YiChenHai7296/PendulumDriveFW/readme.md

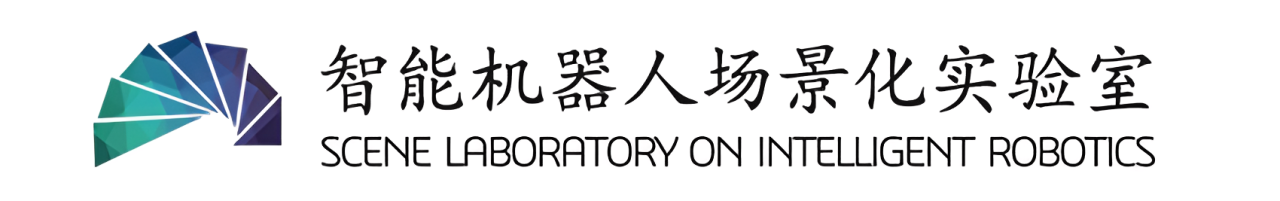
[picture p1: docs/images/IFR.png]
实验室Logo

# PendulumDriveFW
软尺摆 / 倒立摆通用驱动控制板固件工程（当前软件版本 V2.0）。

## 📖 文档

- **[摆系统通用驱动板总体方案V1.0](docs/摆系统通用驱动板总体方案V1.0.md)** — 通用驱动板的硬件与固件系统总体设计说明（需求、电路、软件架构、可测试性）
- **[摆系统单片机程序编码规范V1.2](docs/摆系统单片机程序编码规范V1.2.md)** — 摆系统单片机裸机固件编码规范：分层架构、文件分区、命名与注释约定（V1.2）
- **[摆系统通用驱动板硬件精度测试_260428](docs/摆系统通用驱动板硬件精度测试_260428.md)** — 通用驱动板 PWM 占空比映射与 ADC 采样精度硬件测试记录（V1.2 固件，2026-04-28）

## ✨ 更新日志：

| 版本号  | 修改人 | 日期 | 修改点 |
| ---- | --- | --- | --- |
| V1.0 | YiChenHai(xyf) | 260211 | 第一版完成工程，除摆杆编码器未启用外，基础功能齐全。 |
| V1.1 | YiChenHai(xyf) | 260327 | 初次上电时上传57mA电流采样异常值问题解决：模拟侧未稳定时进行了标定函数调用，上电后延迟再进行初始化； |
| | | | 添加零点标定功能； |
| | | | 摆杆编码器启用。 |
| V1.2 | YiChenHai(xyf) | 260330 | 米勒平台导致的PWM死区问题：以拟合公式消除死区； |
| | | | 驱动层上传数据接口memcpy可能被ISR打断问题。 |
| V1.3 | YiChenHai(xyf) | 260519 | 项目规范化：变量命名、函数命名、文件分区、软件分层； |
| | | | PWM线性映射重新测定：0~95%； |
| | | | 编码器首字节误码问题解决：TC中断切换过慢。 |
| V2.0 | YiChenHai(xyf) | 260622 | 对象选择功能加入； |
| | | | 软尺adc采集dma连续请求开启； |
| | | | 串口2波特率提升至921600； |
| | | | ADC、PWM自测函数以开关调用； |
| | | | 增加《摆系统通用驱动板总体方案V1.0》、《摆系统单片机程序编码规范V1.2》； |
| | | | 增加《摆系统通用驱动板硬件精度测试_260428》； |
| | | | 工程重命名，并按文档重构。 |

## 👤 开发者
contributors (https://github.com/YiChenHai7296/PendulumDriveFW/graphs/contributors)
