YiChenHai7296/PendulumDriveFW/docs/摆系统通用驱动板硬件精度测试_260428.md

# 1  测试目标
本文档记录摆系统通用驱动板在 V1.2 测试固件 下的硬件精度验证，重点确认以下两项是否满足控制与反馈需求：
## 1.1  PWM 给定占空比测试
验证上位机给定占空比经单片机 PWM 映射后，电机 H 桥两侧实际输出占空比是否与给定值一致，为后续占空比标定与转速控制提供依据。

## 1.2  ADC 精度测试
验证两路模拟采样链路的换算精度：
- 电机电流（ADC1 / ADC2）：PWM 高、低电平中心点采样；
- 软尺摆幅电压（ADC3）：外部电压输入采样。

对应系统需求：电流误差 < 10 mA，摆幅电压误差 < 10 mV。

# 2  测试版本

| 项目 | 版本 / 信息 |
| --- | --- |
| 硬件版本 | `DaoLiBai_BaseControlBoard_V2.1_260415` |
| 软件分支 | `SoftscalePendulumDriveBoard_V1.2_PWM+ADCtest_260428` |
| 软件 Commit | `394aa0fff4cecf73253746ea5f10786aba58eab4` |
| 测试日期 | 2026-04-28 |

# 3  测试方法
## 3.1  PWM给定占空比测试
**目的：** 对比「上位机给定占空比」与「示波器实测占空比」，以说明拟合函数的拟合精度。

**步骤：**
1. 在 H 桥输出端（图示引脚）飞出两根短测量线；
2. 差分表笔接入，测量电机两侧实际 PWM 占空比；
3. 上位机按 0.1%～99% 给定多组占空比，记录实测值并计算误差。

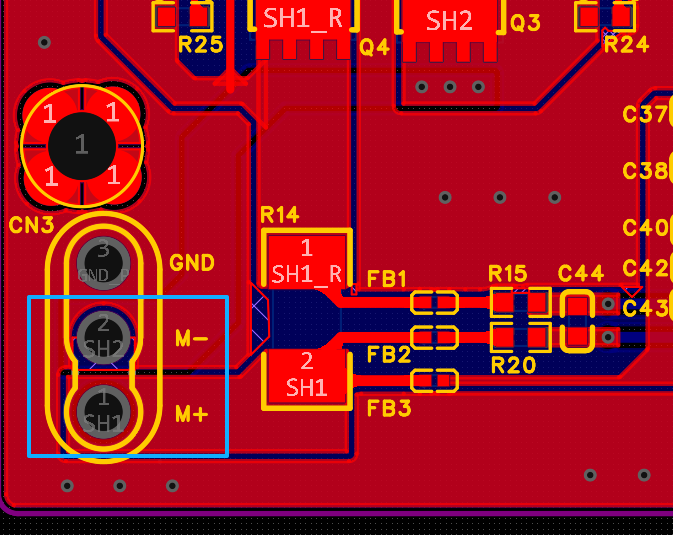
[picture p21: docs/images/硬件精度测试images/图01-PWM测试测量接线示意.png]
图01 PWM测试测量接线示意

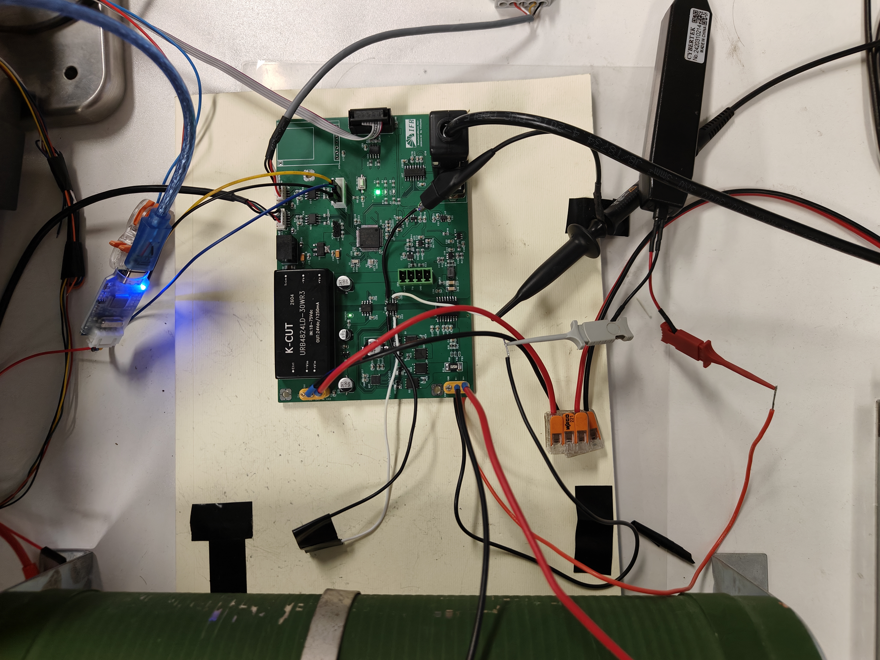
[picture p22: docs/images/硬件精度测试images/图02-PWM测试接线照片1.jpg]
图02 PWM测试接线照片1

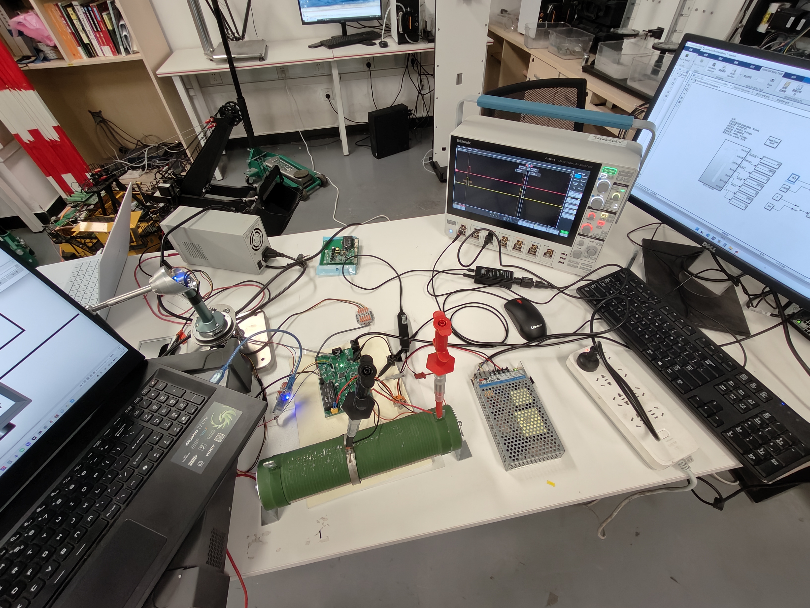
[picture p23: docs/images/硬件精度测试images/图03-PWM测试接线照片2.jpg]
图03 PWM测试接线照片2


## 3.2  ADC精度测试
- 打开调试输出

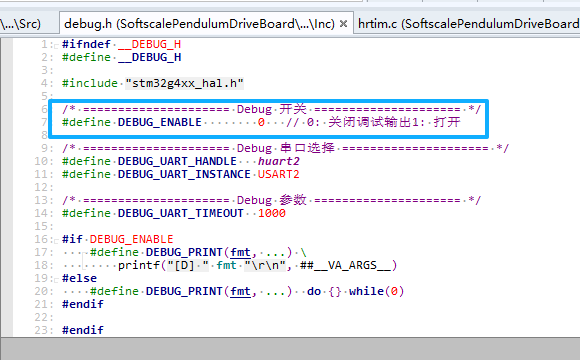
[picture p24: docs/images/硬件精度测试images/图04-打开调试输出.png]
图04 打开调试输出


- 根据实验选择输出模式

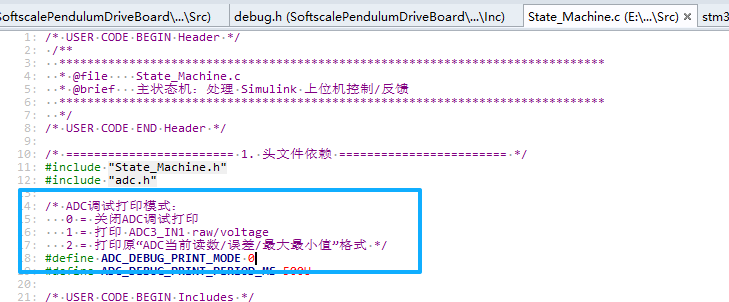
[picture p25: docs/images/硬件精度测试images/图05-选择输出模式.png]
图05 选择输出模式


### 3.2.1  电机ADC测量
**换算公式：**
$$I_{电机}=\frac{V_{adc}−1.6 V}{41×R_{14}}$$

其中 R14=0.002 Ω。

**接线：** 
	图示采样回路处串联电流表和功率电阻，由表计读数得到实际电流；与单片机 ADC 换算电流对比。
图06 电机ADC测量接线示意
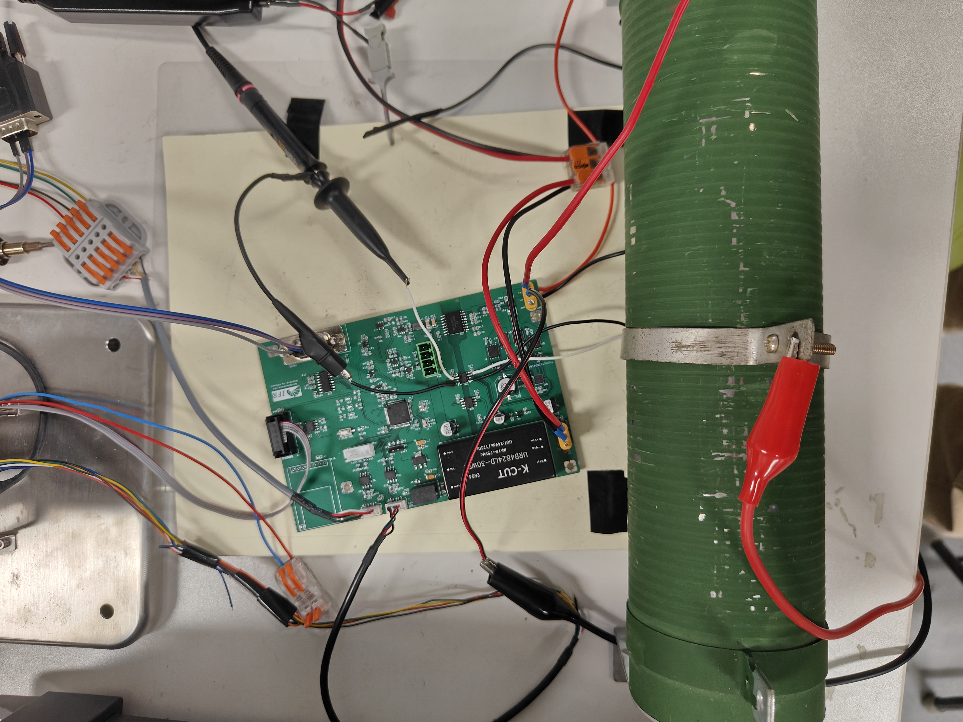
[picture p26: docs/images/硬件精度测试images/图07-电机ADC测量照片1.jpeg]
图07 电机ADC测量照片1

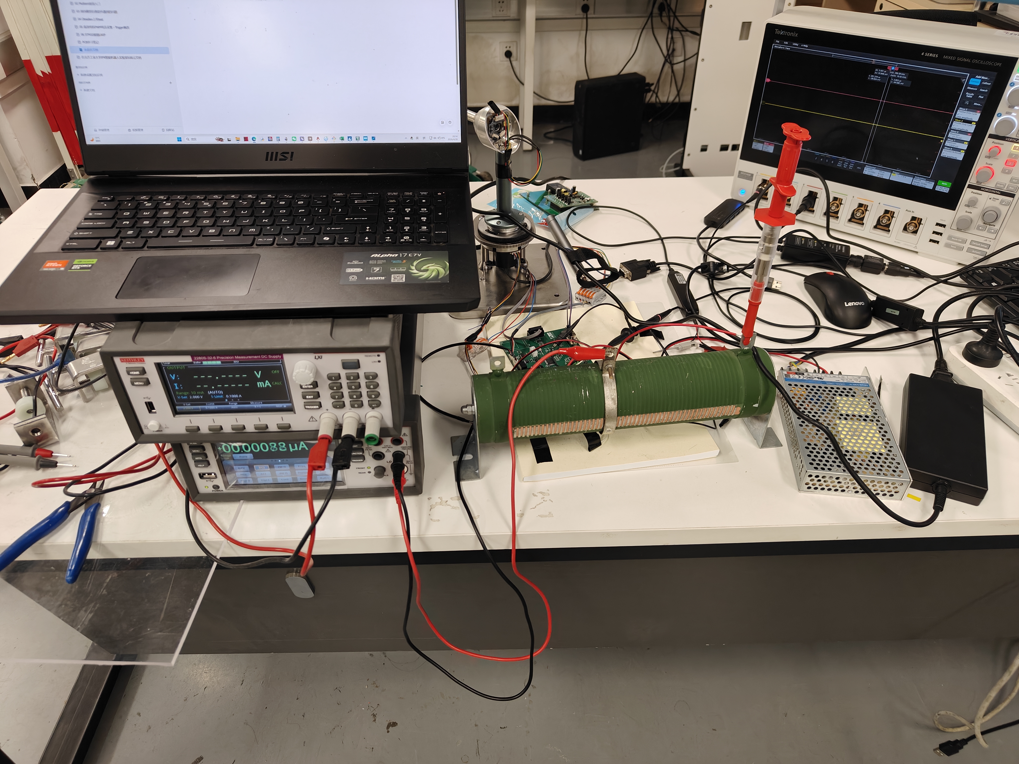
[picture p27: docs/images/硬件精度测试images/图08-电机ADC测量照片2.jpeg]
图08 电机ADC测量照片2

### 3.2.2  软尺摆ADC测量
**换算公式：**
$$V_{in}=\frac{V_{adc}−1.6 V}{0.16}$$

**接线：**
	在图示处直接使用高精度信号发生器**给定测量电压**，经公式计算后与单片机adc读取值比对。
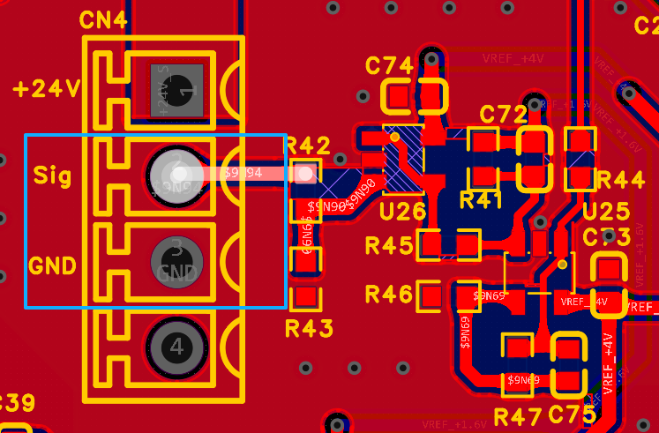
[picture p28: docs/images/硬件精度测试images/图09-软尺摆ADC测量接线示意.png]
图09 软尺摆ADC测量接线示意

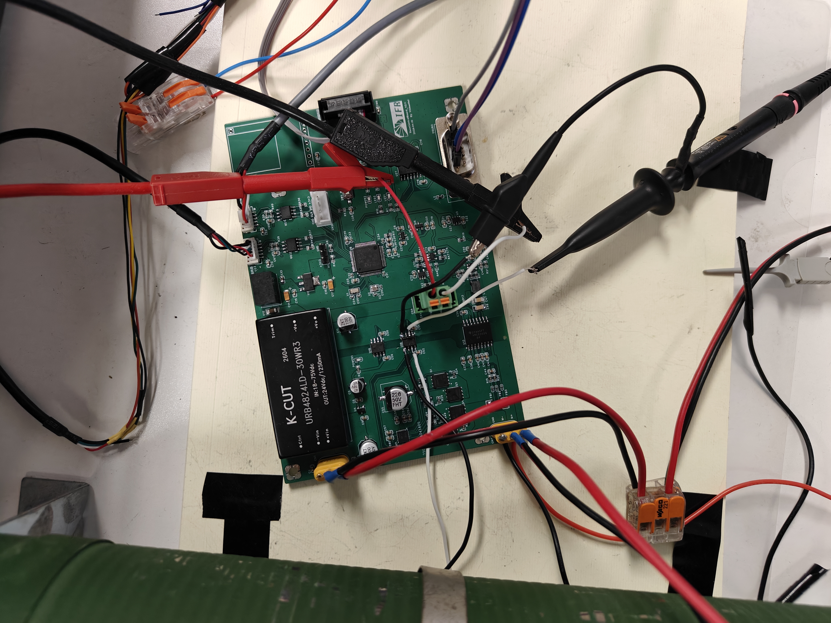
[picture p29: docs/images/硬件精度测试images/图10-软尺摆ADC测量照片1.jpeg]
图10 软尺摆ADC测量照片1

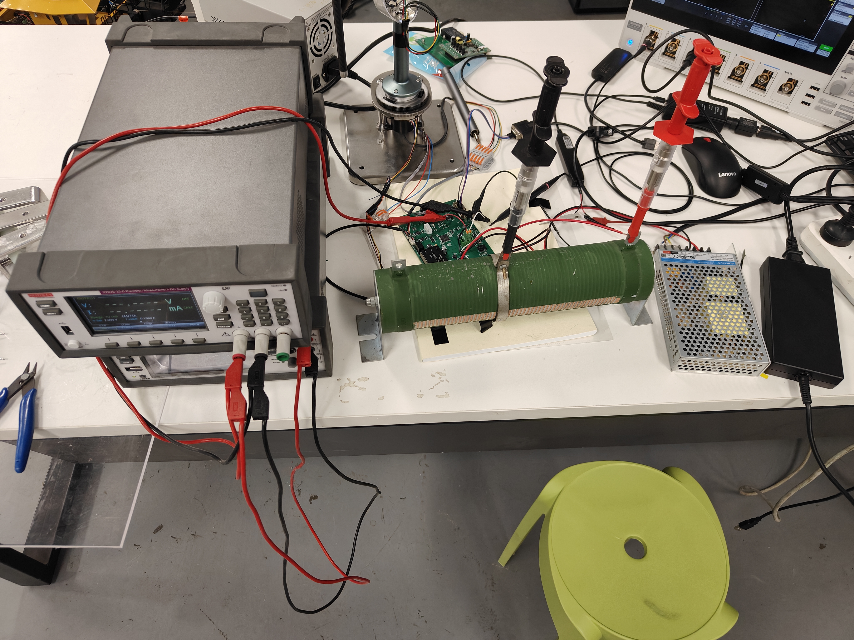
[picture p30: docs/images/硬件精度测试images/图11-软尺摆ADC测量照片2.jpeg]
图11 软尺摆ADC测量照片2

# 4  测试结果
## 4.1  PWM给定测试
### 4.1.1  数据整理
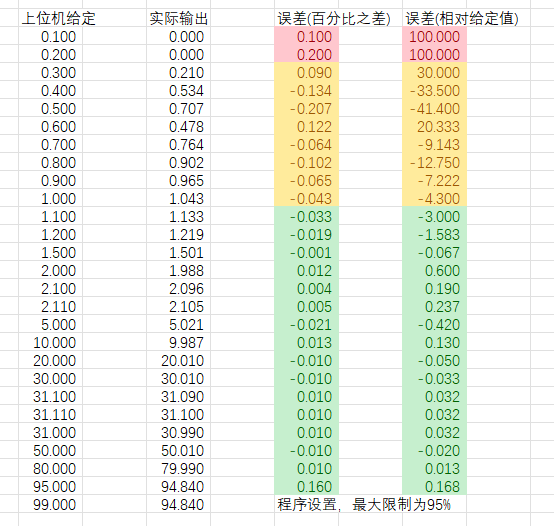
[picture p31: docs/images/硬件精度测试images/图12-PWM测试结果数据整理.png]
图12 PWM测试结果数据整理

### 4.1.2  测试结论

| 给定占空比区间 | 实测表现 | 相对误差（典型） |
| --- | --- | --- |
| 0.1%～0.2% | 实测为 0，无有效输出 | 死区 |
| 0.3%～1.0% | 有输出但偏差较大 | 约 ±30%～±40% |
| ≥ 1.1% | 跟踪明显改善 | 多数 < 3% |
| ≥ 2.0% | 精度稳定 | 多数 < 1%（如 10% 给定误差约 0.13%） |
| 99% 给定 | 实测约 94.84%  | 受固件最大占空比 95% 限制 |

1. 低占空比死区明显： 给定 ≤ 0.2% 时实测为 0，与固件死区阈值（约 0.08%）及驱动芯片、H 桥开启特性一致；0.3%～1.0% 区间误差仍较大，不宜作为精确调速区。
2. 有效调速区精度良好： 给定 ≥ 2.0% 时，相对误差多数 < 1%，满足万分之一给定精度下的实际控制需求。
3. 上限受软件限制： 给定 99% 时输出约 94.84%，与程序 95% 占空比上限 一致，属预期行为。

**结论：** PWM 映射在 ≥ 2% 占空比 范围内可用；低占空比区需依赖标定表/死区补偿，与正式固件 `MOTOR_PWM_USE_FIT_MAPPING` 策略一致。

### 4.1.3  原始数据
见附件 260428 PWM拟合测试示波器截图

## 4.2  ADC精度测试
### 4.2.1  数据整理
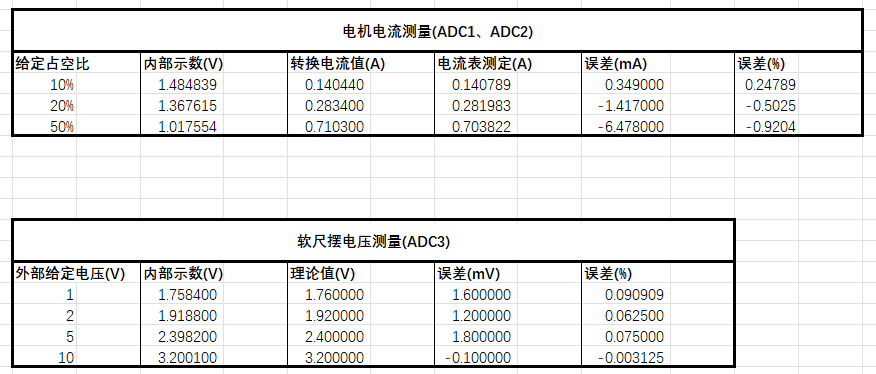
[picture p32: docs/images/硬件精度测试images/图13-ADC测试结果数据整理.png]
图13 ADC测试结果数据整理


### 4.2.2  测试结论
1. 电机电流： 相对误差 < 1%，绝对误差最大约 6.5 mA（50% 工况），满足 < 10 mA 指标。
2. 软尺摆电压： 测试点误差 < 2 mV，相对误差 < 0.1%，满足 < 10 mV 指标。

**结论：** 两路 ADC 采样链路（含隔离放大、偏置与换算公式）精度达标，可作为闭环反馈与软尺摆模式摆幅上报的可靠数据来源。

### 4.2.3  原始数据
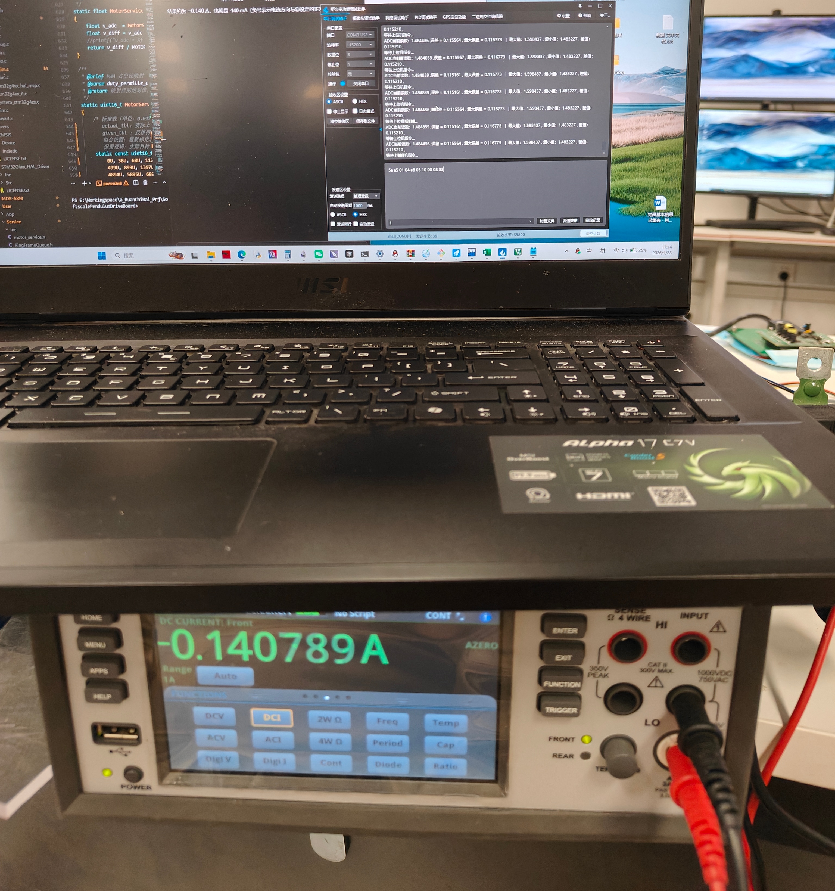
[picture p33: docs/images/硬件精度测试images/图14-ADC原始数据照片1.jpg]
图14 ADC原始数据照片1

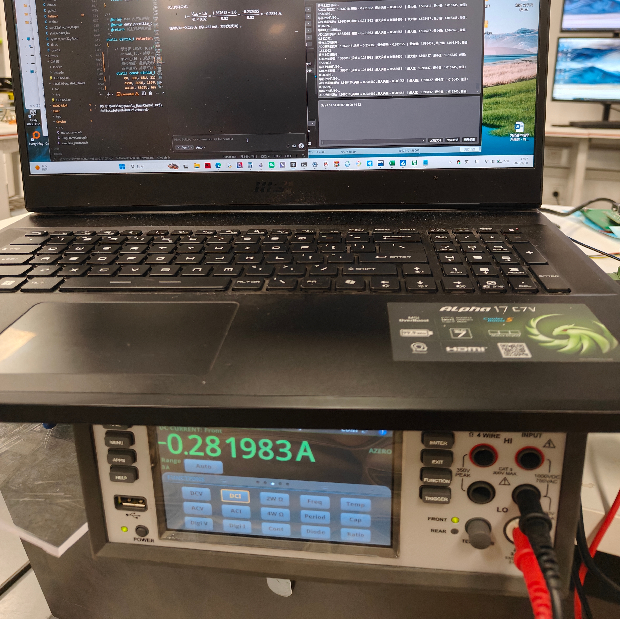
[picture p34: docs/images/硬件精度测试images/图15-ADC原始数据照片2.jpg]
图15 ADC原始数据照片2

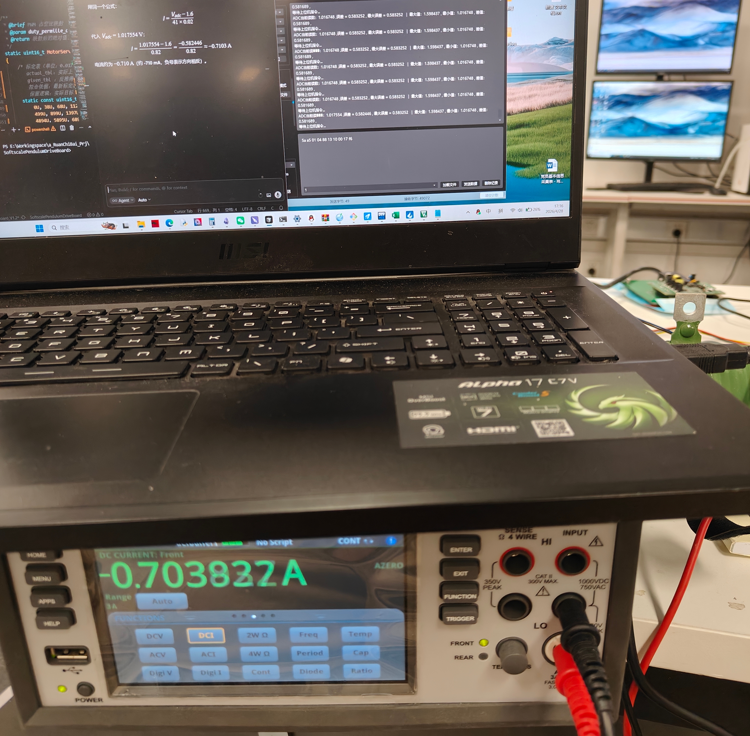
[picture p35: docs/images/硬件精度测试images/图16-ADC原始数据照片3.jpg]
图16 ADC原始数据照片3


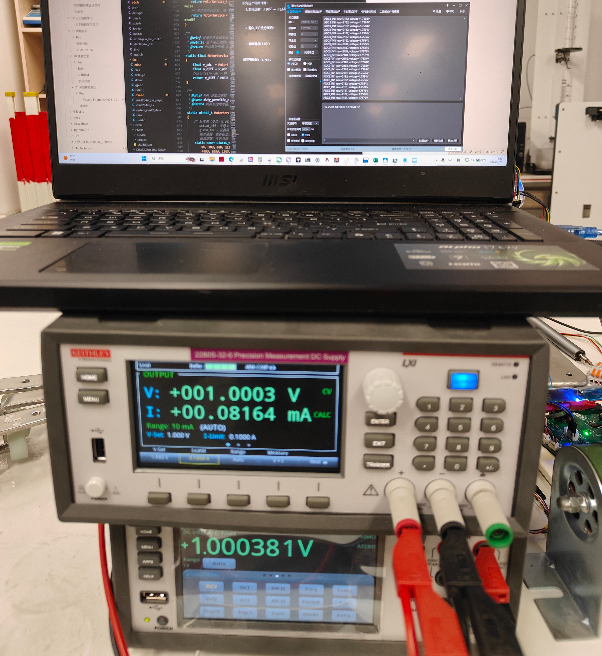
[picture p36: docs/images/硬件精度测试images/图17-ADC原始数据照片4.jpg]
图17 ADC原始数据照片4

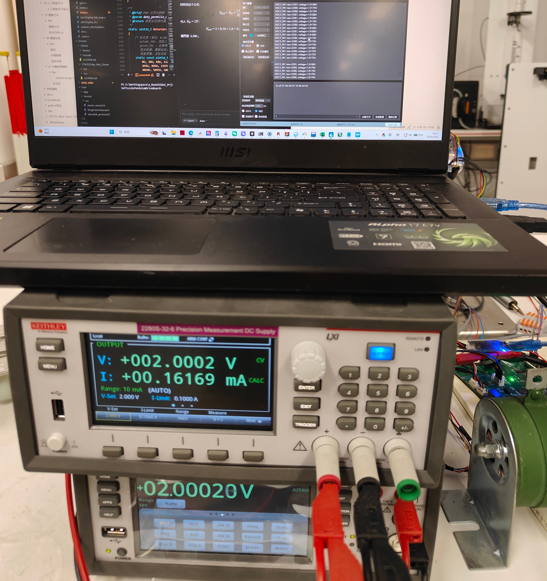
[picture p37: docs/images/硬件精度测试images/图18-ADC原始数据照片5.jpg]
图18 ADC原始数据照片5

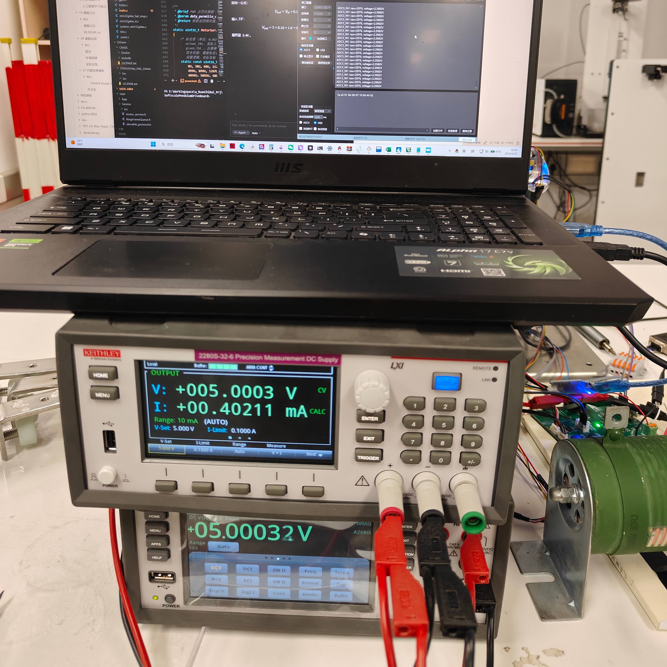
[picture p38: docs/images/硬件精度测试images/图19-ADC原始数据照片6.jpg]
图19 ADC原始数据照片6

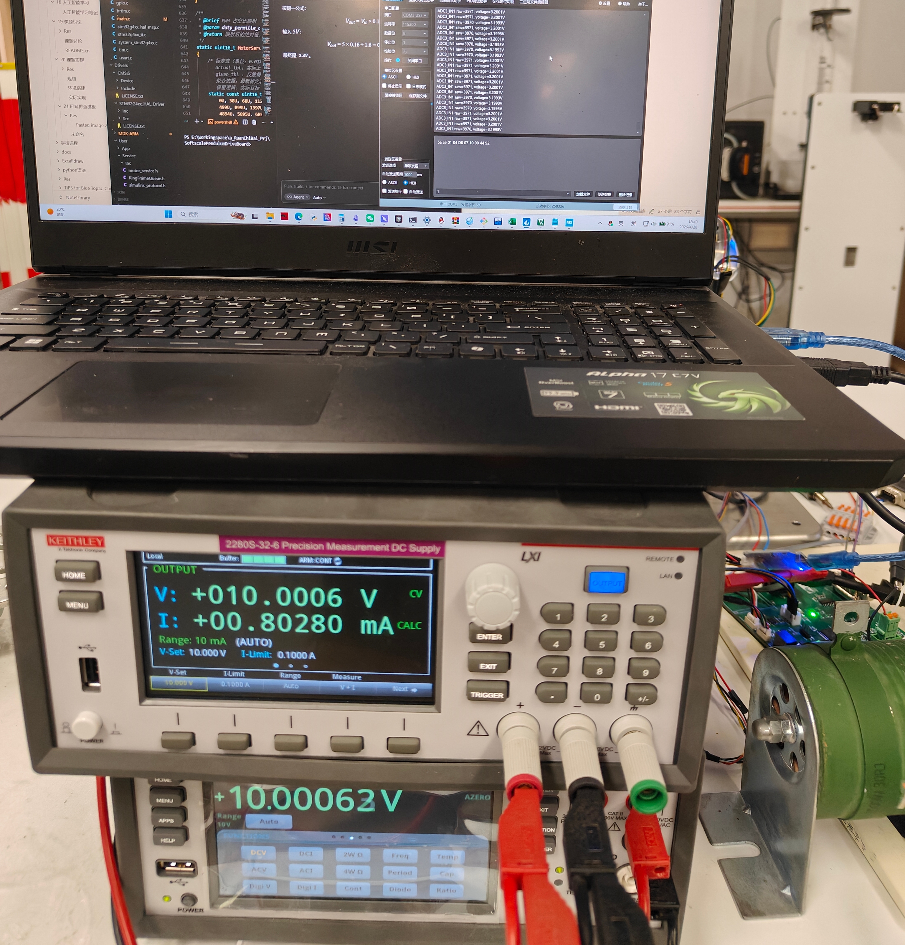
[picture p39: docs/images/硬件精度测试images/图20-ADC原始数据照片7.jpg]
图20 ADC原始数据照片7
