YiChenHai7296/PendulumDriveFW/Core/Src/main.c

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
/* Includes ------------------------------------------------------------------*/
#include "main.h"
#include "hrtim.h"


void SystemClock_Config(void);
/* USER CODE BEGIN 0 */

/* ======================== 1. 头文件引用（本文件额外） ======================== */
#include "bsp.h"              /* Bsp_Init / Bsp_Ms_Delay；Error_Handler 内 BSP_LOG_PRINTF */
#include "adc.h"              /* TEST_DRV+TEST_ADC 自测时调用 Drv_ADC_TEST */
#include "hrtim.h"            /* TEST_DRV+TEST_PWM 自测时调用 Drv_PWM_TEST */
#include "State_Machine.h"    /* App_StateMachine_MainLoop */

/* ======================== 2. 私有宏定义 ======================== */
/*
 * 驱动自测开关 TEST_DRV / TEST_ADC / TEST_PWM 已集中至 `User/Config/Inc/config.h`（调试开关分区），
 * 经上方 bsp.h 透传 config.h 可见，此处仅保留组合合法性校验。
 * - TEST_DRV=0：正常应用，调用 App_StateMachine_MainLoop()（永不返回）。
 * - TEST_DRV=1：进入下方自测死循环；IWDG 仍依赖 TIM2 更新中断内 HAL_IWDG_Refresh。
 * - TEST_ADC 仅在 TEST_DRV=1 时生效：1 周期调用 Drv_ADC_TEST()；0 不调用。
 * - TEST_PWM 仅在 TEST_DRV=1 时生效：1 周期调用 Drv_PWM_TEST()；0 不调用。
 */
#if (TEST_ADC != 0) && (TEST_DRV == 0)
#error "TEST_ADC=1 时必须同时 TEST_DRV=1，否则主循环不会调用 Drv_ADC_TEST"
#endif
#if (TEST_PWM != 0) && (TEST_DRV == 0)
#error "TEST_PWM=1 时必须同时 TEST_DRV=1，否则主循环不会调用 Drv_PWM_TEST"
#endif

/* ======================== 3. 私有类型定义 ======================== */
/* 无 */

/* ======================== 4. 对外变量定义 ======================== */
/* 无 */

/* ======================== 5. 私有变量 ======================== */
/* 无 */

/* ======================== 6. 私有函数声明 ======================== */
/* 无 */

/* USER CODE END 0 */

/**
  * @brief  The application entry point.
  * @retval int
  */
int main(void)
{

  /* MCU Configuration--------------------------------------------------------*/

  /* Reset of all peripherals, Initializes the Flash interface and the Systick. */
  HAL_Init();

  /* Configure the system clock */
  SystemClock_Config();

  /* Initialize all configured peripherals */
  /* USER CODE BEGIN 2 */
  /* 外设 MX 初始化与 HRTIM 启动（HAL_Init / SystemClock_Config 已由上方 Cube 模板完成） */
  Bsp_Init();
  
  /* USER CODE END 2 */

  /* Infinite loop */
  /* USER CODE BEGIN WHILE */
  BSP_LOG_PRINTF_FORCE("\n==========================================================");
  BSP_LOG_PRINTF_FORCE("\n  PendulumDriverFW V%s  ;  控制对象: %s  ;  编译日期: %s %s.\n", VERSION_NUM_STR, APP_CONTROL_OBJECT_NAME_STR, __DATE__, __TIME__);
  BSP_LOG_PRINTF_FORCE("==========================================================\n\n");

#if TEST_DRV
  /* 驱动自测：不调用应用状态机；IWDG 仍依赖 TIM2 更新中断内 HAL_IWDG_Refresh */
  while (1)
  {
#if TEST_ADC
    Drv_ADC_TEST();
    Bsp_Ms_Delay(500);
#endif
#if TEST_PWM
    Drv_PWM_TEST();
#endif
  }
#else
  App_StateMachine_MainLoop();
#endif

  while (1)
  {
    /* USER CODE END WHILE */

    /* USER CODE BEGIN 3 */
  }
  /* USER CODE END 3 */
}

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
/* USER CODE BEGIN 4 */

/* ======================== 7. 接口函数实现 ======================== */
/* 无 */

/* ======================== 8. 私有函数实现 ======================== */
/* 无 */

/* ======================== 9. HAL 回调函数实现 ======================== */
/* 无 */

/* USER CODE END 4 */
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
