YiChenHai7296/PendulumDriveFW/PendulumDriveFW.ioc

Mcu.UserName=STM32G474RETx
PA0.Signal=ADC1_IN1
PA1.Signal=ADC2_IN2
PA11.GPIO_Label=LED_BLUE
PA11.Signal=GPIO_Output
PA12.GPIO_Label=LED_RED
PA12.Signal=GPIO_Output
PA13.Signal=SYS_JTMS-SWDIO
PA14.Signal=SYS_JTCK-SWCLK
PA15.Signal=USART2_RX
PA2.Signal=USART2_TX
PA8.Signal=HRTIM1_CHA1
PB1.Signal=ADC3_IN1
PB10.Signal=USART3_TX
PB11.Signal=USART3_RX
PB4.GPIO_Label=Encoder_Motor_Enable
PB4.Signal=GPIO_Output
PB5.GPIO_Label=MotorEnableControl
PB5.Signal=GPIO_Output
PB6.GPIO_Label=MotorDirectionControl
PB6.Signal=GPIO_Output
PB9.GPIO_Label=Encoder_SwingArm_Enable
PB9.Signal=GPIO_Output
PC10.Signal=UART4_TX
PC11.Signal=UART4_RX
PC12.Signal=UART5_TX
PC13.GPIO_Label=Encoder_OutputShaft_Enable
PC13.Signal=GPIO_Output
PC14-OSC32_IN.Signal=RCC_OSC32_IN
PC15-OSC32_OUT.Signal=RCC_OSC32_OUT
PC4.Signal=USART1_TX
PC5.Signal=USART1_RX
PD2.Signal=UART5_RX
PF0-OSC_IN.Signal=RCC_OSC_IN
PF1-OSC_OUT.Signal=RCC_OSC_OUT
