YiChenHai7296/PendulumDriveFW/Core/Inc/main.h

#define Encoder_OutputShaft_Enable_Pin GPIO_PIN_13
#define Encoder_OutputShaft_Enable_GPIO_Port GPIOC
#define LED_BLUE_Pin GPIO_PIN_11
#define LED_BLUE_GPIO_Port GPIOA
#define LED_RED_Pin GPIO_PIN_12
#define LED_RED_GPIO_Port GPIOA
#define Encoder_Motor_Enable_Pin GPIO_PIN_4
#define Encoder_Motor_Enable_GPIO_Port GPIOB
#define MotorEnableControl_Pin GPIO_PIN_5
#define MotorEnableControl_GPIO_Port GPIOB
#define MotorDirectionControl_Pin GPIO_PIN_6
#define MotorDirectionControl_GPIO_Port GPIOB
#define Encoder_SwingArm_Enable_Pin GPIO_PIN_9
#define Encoder_SwingArm_Enable_GPIO_Port GPIOB
