YiChenHai7296/PendulumDriveFW/Core/Src/adc.c

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
/* Includes ------------------------------------------------------------------*/
#include "adc.h"

/* USER CODE BEGIN 0 */

/* ======================== 1. 头文件引用（本文件额外） ======================== */
#include <stdio.h>
#include "bsp.h"      /* BSP_LOG_PRINTF */

/* ======================== 2. 私有宏定义 ======================== */
#define ADC_DMA_RX_BUFF_LEN 1

/* ======================== 3. 私有类型定义 ======================== */
/* 无 */

/* ======================== 4. 对外变量定义 ======================== */
/* 无 */

/* ======================== 5. 私有变量 ======================== */
static __IO uint16_t s_au16ADC1VolValue[ADC_DMA_RX_BUFF_LEN]; /* 电机电压 ADC1 */
static __IO uint16_t s_au16ADC2VolValue[ADC_DMA_RX_BUFF_LEN];
static __IO uint16_t s_au16ADC3VolValue[ADC_DMA_RX_BUFF_LEN]; /* ADC3_IN1，HRTIM+DMA 循环缓冲 */
static volatile uint32_t s_u32MotorADCRawSnapshotPack = 0U;
static float s_fTestValue = 1.6f;                             /* ADC 测试输入电压值 */

/* ======================== 6. 私有函数声明 ======================== */
/* 无 */

/* USER CODE END 0 */

ADC_HandleTypeDef hadc1;
ADC_HandleTypeDef hadc2;
ADC_HandleTypeDef hadc3;
DMA_HandleTypeDef hdma_adc1;
DMA_HandleTypeDef hdma_adc2;
DMA_HandleTypeDef hdma_adc3;

/* ADC1 init function */
void MX_ADC1_Init(void)
{

  ADC_MultiModeTypeDef multimode = {0};
  ADC_ChannelConfTypeDef sConfig = {0};

  /** Common config
  */
  hadc1.Instance = ADC1;
  hadc1.Init.ClockPrescaler = ADC_CLOCK_SYNC_PCLK_DIV4;
  hadc1.Init.Resolution = ADC_RESOLUTION_12B;
  hadc1.Init.DataAlign = ADC_DATAALIGN_RIGHT;
  hadc1.Init.GainCompensation = 0;
  hadc1.Init.ScanConvMode = ADC_SCAN_DISABLE;
  hadc1.Init.EOCSelection = ADC_EOC_SINGLE_CONV;
  hadc1.Init.LowPowerAutoWait = DISABLE;
  hadc1.Init.ContinuousConvMode = DISABLE;
  hadc1.Init.NbrOfConversion = 1;
  hadc1.Init.DiscontinuousConvMode = DISABLE;
  hadc1.Init.ExternalTrigConv = ADC_EXTERNALTRIG_HRTIM_TRG1;
  hadc1.Init.ExternalTrigConvEdge = ADC_EXTERNALTRIGCONVEDGE_RISING;
  hadc1.Init.DMAContinuousRequests = ENABLE;
  hadc1.Init.Overrun = ADC_OVR_DATA_OVERWRITTEN;
  hadc1.Init.OversamplingMode = ENABLE;
  hadc1.Init.Oversampling.Ratio = ADC_OVERSAMPLING_RATIO_32;
  hadc1.Init.Oversampling.RightBitShift = ADC_RIGHTBITSHIFT_5;
  hadc1.Init.Oversampling.TriggeredMode = ADC_TRIGGEREDMODE_SINGLE_TRIGGER;
  hadc1.Init.Oversampling.OversamplingStopReset = ADC_REGOVERSAMPLING_CONTINUED_MODE;
  if (HAL_ADC_Init(&hadc1) != HAL_OK)
  {
    Error_Handler();
  }

  /** Configure the ADC multi-mode
  */
  multimode.Mode = ADC_MODE_INDEPENDENT;
  if (HAL_ADCEx_MultiModeConfigChannel(&hadc1, &multimode) != HAL_OK)
  {
    Error_Handler();
  }

  /** Configure Regular Channel
  */
  sConfig.Channel = ADC_CHANNEL_1;
  sConfig.Rank = ADC_REGULAR_RANK_1;
  sConfig.SamplingTime = ADC_SAMPLETIME_24CYCLES_5;
  sConfig.SingleDiff = ADC_SINGLE_ENDED;
  sConfig.OffsetNumber = ADC_OFFSET_NONE;
  sConfig.Offset = 0;
  if (HAL_ADC_ConfigChannel(&hadc1, &sConfig) != HAL_OK)
  {
    Error_Handler();
  }
  /* USER CODE BEGIN ADC1_Init 2 */

  Bsp_Ms_Delay(2000);/* 等待模拟前端稳定再校准 */
  if (HAL_ADCEx_Calibration_Start(&hadc1, ADC_SINGLE_ENDED) != HAL_OK)
  {
    Error_Handler();
  }

  if (HAL_ADC_Start_DMA(&hadc1, (uint32_t *)s_au16ADC1VolValue, ADC_DMA_RX_BUFF_LEN) != HAL_OK)
  {
    Error_Handler();
  }
  
  /* USER CODE END ADC1_Init 2 */

}
/* ADC2 init function */
void MX_ADC2_Init(void)
{

  ADC_ChannelConfTypeDef sConfig = {0};

  /** Common config
  */
  hadc2.Instance = ADC2;
  hadc2.Init.ClockPrescaler = ADC_CLOCK_SYNC_PCLK_DIV4;
  hadc2.Init.Resolution = ADC_RESOLUTION_12B;
  hadc2.Init.DataAlign = ADC_DATAALIGN_RIGHT;
  hadc2.Init.GainCompensation = 0;
  hadc2.Init.ScanConvMode = ADC_SCAN_DISABLE;
  hadc2.Init.EOCSelection = ADC_EOC_SINGLE_CONV;
  hadc2.Init.LowPowerAutoWait = DISABLE;
  hadc2.Init.ContinuousConvMode = DISABLE;
  hadc2.Init.NbrOfConversion = 1;
  hadc2.Init.DiscontinuousConvMode = DISABLE;
  hadc2.Init.ExternalTrigConv = ADC_EXTERNALTRIG_HRTIM_TRG6;
  hadc2.Init.ExternalTrigConvEdge = ADC_EXTERNALTRIGCONVEDGE_RISING;
  hadc2.Init.DMAContinuousRequests = ENABLE;
  hadc2.Init.Overrun = ADC_OVR_DATA_OVERWRITTEN;
  hadc2.Init.OversamplingMode = ENABLE;
  hadc2.Init.Oversampling.Ratio = ADC_OVERSAMPLING_RATIO_32;
  hadc2.Init.Oversampling.RightBitShift = ADC_RIGHTBITSHIFT_5;
  hadc2.Init.Oversampling.TriggeredMode = ADC_TRIGGEREDMODE_SINGLE_TRIGGER;
  hadc2.Init.Oversampling.OversamplingStopReset = ADC_REGOVERSAMPLING_CONTINUED_MODE;
  if (HAL_ADC_Init(&hadc2) != HAL_OK)
  {
    Error_Handler();
  }

  /** Configure Regular Channel
  */
  sConfig.Channel = ADC_CHANNEL_2;
  sConfig.Rank = ADC_REGULAR_RANK_1;
  sConfig.SamplingTime = ADC_SAMPLETIME_24CYCLES_5;
  sConfig.SingleDiff = ADC_SINGLE_ENDED;
  sConfig.OffsetNumber = ADC_OFFSET_NONE;
  sConfig.Offset = 0;
  if (HAL_ADC_ConfigChannel(&hadc2, &sConfig) != HAL_OK)
  {
    Error_Handler();
  }
  /* USER CODE BEGIN ADC2_Init 2 */
  if (HAL_ADCEx_Calibration_Start(&hadc2, ADC_SINGLE_ENDED) != HAL_OK)
  {
    Error_Handler();
  }

  if (HAL_ADC_Start_DMA(&hadc2, (uint32_t *)s_au16ADC2VolValue, ADC_DMA_RX_BUFF_LEN) != HAL_OK)
  {
    Error_Handler();
  }


  /* USER CODE END ADC2_Init 2 */

}
/* ADC3 init function */
void MX_ADC3_Init(void)
{

  ADC_MultiModeTypeDef multimode = {0};
  ADC_ChannelConfTypeDef sConfig = {0};

  /** Common config
  */
  hadc3.Instance = ADC3;
  hadc3.Init.ClockPrescaler = ADC_CLOCK_SYNC_PCLK_DIV4;
  hadc3.Init.Resolution = ADC_RESOLUTION_12B;
  hadc3.Init.DataAlign = ADC_DATAALIGN_RIGHT;
  hadc3.Init.GainCompensation = 0;
  hadc3.Init.ScanConvMode = ADC_SCAN_DISABLE;
  hadc3.Init.EOCSelection = ADC_EOC_SINGLE_CONV;
  hadc3.Init.LowPowerAutoWait = DISABLE;
  hadc3.Init.ContinuousConvMode = DISABLE;
  hadc3.Init.NbrOfConversion = 1;
  hadc3.Init.DiscontinuousConvMode = DISABLE;
  hadc3.Init.ExternalTrigConv = ADC_EXTERNALTRIG_HRTIM_TRG6;
  hadc3.Init.ExternalTrigConvEdge = ADC_EXTERNALTRIGCONVEDGE_RISING;
  hadc3.Init.DMAContinuousRequests = ENABLE;
  hadc3.Init.Overrun = ADC_OVR_DATA_PRESERVED;
  hadc3.Init.OversamplingMode = ENABLE;
  hadc3.Init.Oversampling.Ratio = ADC_OVERSAMPLING_RATIO_32;
  hadc3.Init.Oversampling.RightBitShift = ADC_RIGHTBITSHIFT_5;
  hadc3.Init.Oversampling.TriggeredMode = ADC_TRIGGEREDMODE_SINGLE_TRIGGER;
  hadc3.Init.Oversampling.OversamplingStopReset = ADC_REGOVERSAMPLING_CONTINUED_MODE;
  if (HAL_ADC_Init(&hadc3) != HAL_OK)
  {
    Error_Handler();
  }

  /** Configure the ADC multi-mode
  */
  multimode.Mode = ADC_MODE_INDEPENDENT;
  if (HAL_ADCEx_MultiModeConfigChannel(&hadc3, &multimode) != HAL_OK)
  {
    Error_Handler();
  }

  /** Configure Regular Channel
  */
  sConfig.Channel = ADC_CHANNEL_1;
  sConfig.Rank = ADC_REGULAR_RANK_1;
  sConfig.SamplingTime = ADC_SAMPLETIME_24CYCLES_5;
  sConfig.SingleDiff = ADC_SINGLE_ENDED;
  sConfig.OffsetNumber = ADC_OFFSET_NONE;
  sConfig.Offset = 0;
  if (HAL_ADC_ConfigChannel(&hadc3, &sConfig) != HAL_OK)
  {
    Error_Handler();
  }
  /* USER CODE BEGIN ADC3_Init 2 */
  if (HAL_ADCEx_Calibration_Start(&hadc3, ADC_SINGLE_ENDED) != HAL_OK)
  {
    Error_Handler();
  }

  if (HAL_ADC_Start_DMA(&hadc3, (uint32_t *)s_au16ADC3VolValue, ADC_DMA_RX_BUFF_LEN) != HAL_OK)
  {
    Error_Handler();
  }

  /* USER CODE END ADC3_Init 2 */

}

static uint32_t HAL_RCC_ADC12_CLK_ENABLED=0;

void HAL_ADC_MspInit(ADC_HandleTypeDef* adcHandle)
{

  GPIO_InitTypeDef GPIO_InitStruct = {0};
  RCC_PeriphCLKInitTypeDef PeriphClkInit = {0};
  if(adcHandle->Instance==ADC1)
  {
  /** Initializes the peripherals clocks
  */
    PeriphClkInit.PeriphClockSelection = RCC_PERIPHCLK_ADC12;
    PeriphClkInit.Adc12ClockSelection = RCC_ADC12CLKSOURCE_SYSCLK;
    if (HAL_RCCEx_PeriphCLKConfig(&PeriphClkInit) != HAL_OK)
    {
      Error_Handler();
    }

    /* ADC1 clock enable */
    HAL_RCC_ADC12_CLK_ENABLED++;
    if(HAL_RCC_ADC12_CLK_ENABLED==1){
      __HAL_RCC_ADC12_CLK_ENABLE();
    }

    __HAL_RCC_GPIOA_CLK_ENABLE();
    /**ADC1 GPIO Configuration
    PA0     ------> ADC1_IN1
    */
    GPIO_InitStruct.Pin = GPIO_PIN_0;
    GPIO_InitStruct.Mode = GPIO_MODE_ANALOG;
    GPIO_InitStruct.Pull = GPIO_NOPULL;
    HAL_GPIO_Init(GPIOA, &GPIO_InitStruct);

    /* ADC1 DMA Init */
    /* ADC1 Init */
    hdma_adc1.Instance = DMA1_Channel1;
    hdma_adc1.Init.Request = DMA_REQUEST_ADC1;
    hdma_adc1.Init.Direction = DMA_PERIPH_TO_MEMORY;
    hdma_adc1.Init.PeriphInc = DMA_PINC_DISABLE;
    hdma_adc1.Init.MemInc = DMA_MINC_ENABLE;
    hdma_adc1.Init.PeriphDataAlignment = DMA_PDATAALIGN_HALFWORD;
    hdma_adc1.Init.MemDataAlignment = DMA_MDATAALIGN_HALFWORD;
    hdma_adc1.Init.Mode = DMA_CIRCULAR;
    hdma_adc1.Init.Priority = DMA_PRIORITY_MEDIUM;
    if (HAL_DMA_Init(&hdma_adc1) != HAL_OK)
    {
      Error_Handler();
    }

    __HAL_LINKDMA(adcHandle,DMA_Handle,hdma_adc1);

  }
  else if(adcHandle->Instance==ADC2)
  {
  /** Initializes the peripherals clocks
  */
    PeriphClkInit.PeriphClockSelection = RCC_PERIPHCLK_ADC12;
    PeriphClkInit.Adc12ClockSelection = RCC_ADC12CLKSOURCE_SYSCLK;
    if (HAL_RCCEx_PeriphCLKConfig(&PeriphClkInit) != HAL_OK)
    {
      Error_Handler();
    }

    /* ADC2 clock enable */
    HAL_RCC_ADC12_CLK_ENABLED++;
    if(HAL_RCC_ADC12_CLK_ENABLED==1){
      __HAL_RCC_ADC12_CLK_ENABLE();
    }

    __HAL_RCC_GPIOA_CLK_ENABLE();
    /**ADC2 GPIO Configuration
    PA1     ------> ADC2_IN2
    */
    GPIO_InitStruct.Pin = GPIO_PIN_1;
    GPIO_InitStruct.Mode = GPIO_MODE_ANALOG;
    GPIO_InitStruct.Pull = GPIO_NOPULL;
    HAL_GPIO_Init(GPIOA, &GPIO_InitStruct);

    /* ADC2 DMA Init */
    /* ADC2 Init */
    hdma_adc2.Instance = DMA1_Channel2;
    hdma_adc2.Init.Request = DMA_REQUEST_ADC2;
    hdma_adc2.Init.Direction = DMA_PERIPH_TO_MEMORY;
    hdma_adc2.Init.PeriphInc = DMA_PINC_DISABLE;
    hdma_adc2.Init.MemInc = DMA_MINC_ENABLE;
    hdma_adc2.Init.PeriphDataAlignment = DMA_PDATAALIGN_HALFWORD;
    hdma_adc2.Init.MemDataAlignment = DMA_MDATAALIGN_HALFWORD;
    hdma_adc2.Init.Mode = DMA_CIRCULAR;
    hdma_adc2.Init.Priority = DMA_PRIORITY_MEDIUM;
    if (HAL_DMA_Init(&hdma_adc2) != HAL_OK)
    {
      Error_Handler();
    }

    __HAL_LINKDMA(adcHandle,DMA_Handle,hdma_adc2);

  }
  else if(adcHandle->Instance==ADC3)
  {
  /** Initializes the peripherals clocks
  */
    PeriphClkInit.PeriphClockSelection = RCC_PERIPHCLK_ADC345;
    PeriphClkInit.Adc345ClockSelection = RCC_ADC345CLKSOURCE_SYSCLK;
    if (HAL_RCCEx_PeriphCLKConfig(&PeriphClkInit) != HAL_OK)
    {
      Error_Handler();
    }

    /* ADC3 clock enable */
    __HAL_RCC_ADC345_CLK_ENABLE();

    __HAL_RCC_GPIOB_CLK_ENABLE();
    /**ADC3 GPIO Configuration
    PB1     ------> ADC3_IN1
    */
    GPIO_InitStruct.Pin = GPIO_PIN_1;
    GPIO_InitStruct.Mode = GPIO_MODE_ANALOG;
    GPIO_InitStruct.Pull = GPIO_NOPULL;
    HAL_GPIO_Init(GPIOB, &GPIO_InitStruct);

    /* ADC3 DMA Init */
    /* ADC3 Init */
    hdma_adc3.Instance = DMA1_Channel5;
    hdma_adc3.Init.Request = DMA_REQUEST_ADC3;
    hdma_adc3.Init.Direction = DMA_PERIPH_TO_MEMORY;
    hdma_adc3.Init.PeriphInc = DMA_PINC_DISABLE;
    hdma_adc3.Init.MemInc = DMA_MINC_ENABLE;
    hdma_adc3.Init.PeriphDataAlignment = DMA_PDATAALIGN_HALFWORD;
    hdma_adc3.Init.MemDataAlignment = DMA_MDATAALIGN_HALFWORD;
    hdma_adc3.Init.Mode = DMA_CIRCULAR;
    hdma_adc3.Init.Priority = DMA_PRIORITY_MEDIUM;
    if (HAL_DMA_Init(&hdma_adc3) != HAL_OK)
    {
      Error_Handler();
    }

    __HAL_LINKDMA(adcHandle,DMA_Handle,hdma_adc3);

  }
}

void HAL_ADC_MspDeInit(ADC_HandleTypeDef* adcHandle)
{

  if(adcHandle->Instance==ADC1)
  {
    /* Peripheral clock disable */
    HAL_RCC_ADC12_CLK_ENABLED--;
    if(HAL_RCC_ADC12_CLK_ENABLED==0){
      __HAL_RCC_ADC12_CLK_DISABLE();
    }

    /**ADC1 GPIO Configuration
    PA0     ------> ADC1_IN1
    */
    HAL_GPIO_DeInit(GPIOA, GPIO_PIN_0);

    /* ADC1 DMA DeInit */
    HAL_DMA_DeInit(adcHandle->DMA_Handle);
  }
  else if(adcHandle->Instance==ADC2)
  {
    /* Peripheral clock disable */
    HAL_RCC_ADC12_CLK_ENABLED--;
    if(HAL_RCC_ADC12_CLK_ENABLED==0){
      __HAL_RCC_ADC12_CLK_DISABLE();
    }

    /**ADC2 GPIO Configuration
    PA1     ------> ADC2_IN2
    */
    HAL_GPIO_DeInit(GPIOA, GPIO_PIN_1);

    /* ADC2 DMA DeInit */
    HAL_DMA_DeInit(adcHandle->DMA_Handle);
  }
  else if(adcHandle->Instance==ADC3)
  {
    /* Peripheral clock disable */
    __HAL_RCC_ADC345_CLK_DISABLE();

    /**ADC3 GPIO Configuration
    PB1     ------> ADC3_IN1
    */
    HAL_GPIO_DeInit(GPIOB, GPIO_PIN_1);

    /* ADC3 DMA DeInit */
    HAL_DMA_DeInit(adcHandle->DMA_Handle);
  }
}

/* USER CODE BEGIN 1 */

/* ======================== 7. 接口函数实现 ======================== */

/* -------- 7.1 上层接口（与 .h 5.1 对应） -------- */

/**
  * @brief  读取 ADC1、ADC2 快照中的原始采样值（各 12 位有效）
  * @note   数据来自 Drv_Loc_ADC_Motor_RawData_Snapshot 写入的快照；本函数将 32 位快照一次拆成两路，
  *         避免两次读 16 位期间被更新导致跨周期混叠。
  * @param  pOut  至少 2 个 uint16_t：pOut[0]=ADC1，pOut[1]=ADC2
  * @retval STATUS_OK 写入成功；STATUS_ERROR 指针无效（pOut 为 NULL）
  */
Status_t Drv_ADC_Motor_RawData_Read(uint16_t *pOut)
{
    uint32_t u32RawPack;

    if (pOut == NULL)
    {
        return STATUS_ERROR;
    }

    u32RawPack = s_u32MotorADCRawSnapshotPack;
    pOut[0] = (uint16_t)(u32RawPack & 0xFFFFU);
    pOut[1] = (uint16_t)((u32RawPack >> 16) & 0xFFFFU);
    return STATUS_OK;
}

/**
  * @brief  读取 SoftRuler 通道（ADC3_IN1）当前 DMA 缓冲中的原始值（12 位有效）
  * @details HRTIM 外触发 + DMA 循环（与 ADC1/2 同类）；ADC3 接 HRTIM TRG6（TimerA CMP2），
  *          非 ADC1 的 TRG1（TimerA CMP3）；单通道单 halfword，无需 32 位快照打包。
  * @param[out] pOut 输出 1 个 uint16_t
  * @retval STATUS_OK / STATUS_ERROR（pOut 为空）
  */
Status_t Drv_ADC_SoftRuler_RawData_Read(uint16_t *pOut)
{
    if (pOut == NULL)
    {
        return STATUS_ERROR;
    }

    *pOut = s_au16ADC3VolValue[0];
    return STATUS_OK;
}

/**
 * @brief  ADC 自测：读取电机 ADC1/ADC2 与软尺摆 ADC3 原始值，换算电压/理论电流并经调试串口打印
 * @note   仅用于开发期联调（受 main.c 的 TEST_ADC 开关控制）；电机两路读自中断快照，软尺摆读自 DMA 缓冲
 */
void Drv_ADC_TEST(void)
{
    uint16_t au16MotorRaw[2];
    uint16_t u16SoftRaw;
    float     fVmotor1;
    float     fVmotor2;
    float     fVsoft;
    float     fImotor1Theory;
    float     fImotor2Theory;
    float     fVinSoftTheory;
    const float fOffsetV       = 1.6f;   /* 运放/偏置扣除 */
    const float fMotorGain     = 41.0f;  /* 电流放大倍数 */
    const float fShuntOhm      = 0.02f;  /* 采样电阻 20 mΩ */
    const float fSoftVinDiv    = 0.16f;  /* 软尺摆幅侧：(Vadc-1.6)/0.16 → 输入电压理论值 */

    /* 电机快照仅由中断里 `Drv_Loc_ADC_Motor_RawData_Snapshot` 更新；此处只读上次快照 */
    if (Drv_ADC_Motor_RawData_Read(au16MotorRaw) != STATUS_OK)
    {
        BSP_LOG_PRINTF("[ADC_TEST] Drv_ADC_Motor_RawData_Read fail\r\n");
        return;
    }

    if (Drv_ADC_SoftRuler_RawData_Read(&u16SoftRaw) != STATUS_OK)
    {
        BSP_LOG_PRINTF("[ADC_TEST] Drv_ADC_SoftRuler_RawData_Read fail\r\n");
        return;
    }

    fVmotor1 = (float)au16MotorRaw[0] * ADC_REFERENCE_VOLTAGE_V / ADC_RAW_FULL_RESOLUTION;
    fVmotor2 = (float)au16MotorRaw[1] * ADC_REFERENCE_VOLTAGE_V / ADC_RAW_FULL_RESOLUTION;
    fVsoft   = (float)u16SoftRaw * ADC_REFERENCE_VOLTAGE_V / ADC_RAW_FULL_RESOLUTION;

    /* 电机侧理论电流(A)：(Vadc-1.6)/41/20mΩ */
    fImotor1Theory = (fVmotor1 - fOffsetV) / fMotorGain / fShuntOhm;
    fImotor2Theory = (fVmotor2 - fOffsetV) / fMotorGain / fShuntOhm;
    /* 软尺摆幅侧理论输入电压(V)：(Vadc-1.6)/0.16 */
    fVinSoftTheory = (fVsoft - fOffsetV) / fSoftVinDiv;

    BSP_LOG_PRINTF("\n[ADC_TEST] motor(ADC1) raw=%u ; V=%.4f ; I_theory=%.4fA\r\n",
           (unsigned int)au16MotorRaw[0], (double)fVmotor1, (double)fImotor1Theory);
    BSP_LOG_PRINTF("[ADC_TEST] motor(ADC2) raw=%u ; V=%.4f ; I_theory=%.4fA\r\n",
           (unsigned int)au16MotorRaw[1], (double)fVmotor2, (double)fImotor2Theory);
    BSP_LOG_PRINTF("[ADC_TEST] SoftRuler(ADC3) raw=%u ; V=%.4f ; Vin_theory=%.4fV\r\n",
           (unsigned int)u16SoftRaw, (double)fVsoft, (double)fVinSoftTheory);
}

/* -------- 7.2 层内接口（Drv_Loc_*，与 .h 5.2 对应） -------- */

/**
 * @brief  抓取电机电流 ADC1/ADC2 当前值，打包为单个 32 位快照（低 16 位=ADC1，高 16 位=ADC2）
 * @note   由 HRTIM TimerA CMP1 中断调用，与采样相位对齐；单次 32 位写入保证读侧拆包不跨周期混叠
 */
void Drv_Loc_ADC_Motor_RawData_Snapshot(void)
{
    uint32_t u32RawPack = ((uint32_t)s_au16ADC2VolValue[0] << 16) |
                          (uint32_t)s_au16ADC1VolValue[0];
    s_u32MotorADCRawSnapshotPack = u32RawPack;
}

/* ======================== 8. 私有函数实现 ======================== */
/* 无 */

/* ======================== 9. HAL 回调函数实现 ======================== */
/* 无 */

/* USER CODE END 1 */
