YiChenHai7296/PendulumDriveFW/Core/Src/tim.c

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
/* Includes ------------------------------------------------------------------*/
#include "tim.h"

/* USER CODE BEGIN 0 */

/* ======================== 1. 头文件引用（本文件额外） ======================== */
#include "iwdg.h"

/* ======================== 2. 私有宏定义 ======================== */
/** TIM2 UEV 周期约 200ms（PSC=1699、ARR=19999、TIMCLK≈170MHz） */
#define TIM2_UVE_PERIOD_MS          200U
/** LED_BLUE 翻转周期 */
#define LED_BLUE_TOGGLE_MS          1000U
#define LED_BLUE_TOGGLE_TICKS       (LED_BLUE_TOGGLE_MS / TIM2_UVE_PERIOD_MS)

/* ======================== 3. 私有类型定义 ======================== */
/* 无 */

/* ======================== 4. 对外变量定义 ======================== */
/* 无 */

/* ======================== 5. 私有变量 ======================== */
/* 无 */

/* ======================== 6. 私有函数声明 ======================== */
/* 无 */

/* USER CODE END 0 */

TIM_HandleTypeDef htim1;
TIM_HandleTypeDef htim2;

/* TIM1 init function */
void MX_TIM1_Init(void)
{

  TIM_ClockConfigTypeDef sClockSourceConfig = {0};
  TIM_MasterConfigTypeDef sMasterConfig = {0};
  TIM_OC_InitTypeDef sConfigOC = {0};
  TIM_BreakDeadTimeConfigTypeDef sBreakDeadTimeConfig = {0};

  htim1.Instance = TIM1;
  htim1.Init.Prescaler = 17-1;
  htim1.Init.CounterMode = TIM_COUNTERMODE_UP;
  htim1.Init.Period = 9999;
  htim1.Init.ClockDivision = TIM_CLOCKDIVISION_DIV1;
  htim1.Init.RepetitionCounter = 0;
  htim1.Init.AutoReloadPreload = TIM_AUTORELOAD_PRELOAD_ENABLE;
  if (HAL_TIM_Base_Init(&htim1) != HAL_OK)
  {
    Error_Handler();
  }
  sClockSourceConfig.ClockSource = TIM_CLOCKSOURCE_INTERNAL;
  if (HAL_TIM_ConfigClockSource(&htim1, &sClockSourceConfig) != HAL_OK)
  {
    Error_Handler();
  }
  if (HAL_TIM_OC_Init(&htim1) != HAL_OK)
  {
    Error_Handler();
  }
  sMasterConfig.MasterOutputTrigger = TIM_TRGO_RESET;
  sMasterConfig.MasterOutputTrigger2 = TIM_TRGO2_RESET;
  sMasterConfig.MasterSlaveMode = TIM_MASTERSLAVEMODE_DISABLE;
  if (HAL_TIMEx_MasterConfigSynchronization(&htim1, &sMasterConfig) != HAL_OK)
  {
    Error_Handler();
  }
  sConfigOC.OCMode = TIM_OCMODE_TOGGLE;
  sConfigOC.Pulse = 1999;
  sConfigOC.OCPolarity = TIM_OCPOLARITY_HIGH;
  sConfigOC.OCNPolarity = TIM_OCNPOLARITY_HIGH;
  sConfigOC.OCFastMode = TIM_OCFAST_DISABLE;
  sConfigOC.OCIdleState = TIM_OCIDLESTATE_RESET;
  sConfigOC.OCNIdleState = TIM_OCNIDLESTATE_RESET;
  if (HAL_TIM_OC_ConfigChannel(&htim1, &sConfigOC, TIM_CHANNEL_1) != HAL_OK)
  {
    Error_Handler();
  }
  sConfigOC.OCMode = TIM_OCMODE_TIMING;
  sConfigOC.Pulse = 3999;
  if (HAL_TIM_OC_ConfigChannel(&htim1, &sConfigOC, TIM_CHANNEL_2) != HAL_OK)
  {
    Error_Handler();
  }
  sBreakDeadTimeConfig.OffStateRunMode = TIM_OSSR_DISABLE;
  sBreakDeadTimeConfig.OffStateIDLEMode = TIM_OSSI_DISABLE;
  sBreakDeadTimeConfig.LockLevel = TIM_LOCKLEVEL_OFF;
  sBreakDeadTimeConfig.DeadTime = 0;
  sBreakDeadTimeConfig.BreakState = TIM_BREAK_DISABLE;
  sBreakDeadTimeConfig.BreakPolarity = TIM_BREAKPOLARITY_HIGH;
  sBreakDeadTimeConfig.BreakFilter = 0;
  sBreakDeadTimeConfig.BreakAFMode = TIM_BREAK_AFMODE_INPUT;
  sBreakDeadTimeConfig.Break2State = TIM_BREAK2_DISABLE;
  sBreakDeadTimeConfig.Break2Polarity = TIM_BREAK2POLARITY_HIGH;
  sBreakDeadTimeConfig.Break2Filter = 0;
  sBreakDeadTimeConfig.Break2AFMode = TIM_BREAK_AFMODE_INPUT;
  sBreakDeadTimeConfig.AutomaticOutput = TIM_AUTOMATICOUTPUT_DISABLE;
  if (HAL_TIMEx_ConfigBreakDeadTime(&htim1, &sBreakDeadTimeConfig) != HAL_OK)
  {
    Error_Handler();
  }
  /* USER CODE BEGIN TIM1_Init 2 */
  HAL_TIM_Base_Start_IT(&htim1);
  HAL_TIM_OC_Start_IT(&htim1, TIM_CHANNEL_1);
  HAL_TIM_OC_Start_IT(&htim1, TIM_CHANNEL_2);
  /* USER CODE END TIM1_Init 2 */

}
/* TIM2 init function */
void MX_TIM2_Init(void)
{

  TIM_ClockConfigTypeDef sClockSourceConfig = {0};
  TIM_MasterConfigTypeDef sMasterConfig = {0};

  htim2.Instance = TIM2;
  htim2.Init.Prescaler = 1700-1;
  htim2.Init.CounterMode = TIM_COUNTERMODE_UP;
  htim2.Init.Period = 19999;
  htim2.Init.ClockDivision = TIM_CLOCKDIVISION_DIV1;
  htim2.Init.AutoReloadPreload = TIM_AUTORELOAD_PRELOAD_DISABLE;
  if (HAL_TIM_Base_Init(&htim2) != HAL_OK)
  {
    Error_Handler();
  }
  sClockSourceConfig.ClockSource = TIM_CLOCKSOURCE_INTERNAL;
  if (HAL_TIM_ConfigClockSource(&htim2, &sClockSourceConfig) != HAL_OK)
  {
    Error_Handler();
  }
  sMasterConfig.MasterOutputTrigger = TIM_TRGO_RESET;
  sMasterConfig.MasterSlaveMode = TIM_MASTERSLAVEMODE_DISABLE;
  if (HAL_TIMEx_MasterConfigSynchronization(&htim2, &sMasterConfig) != HAL_OK)
  {
    Error_Handler();
  }
  /* USER CODE BEGIN TIM2_Init 2 */
  if (HAL_TIM_Base_Start_IT(&htim2) != HAL_OK)
  {
    Error_Handler();
  }
  /* USER CODE END TIM2_Init 2 */

}

void HAL_TIM_Base_MspInit(TIM_HandleTypeDef* tim_baseHandle)
{

  if(tim_baseHandle->Instance==TIM1)
  {
    /* TIM1 clock enable */
    __HAL_RCC_TIM1_CLK_ENABLE();

    /* TIM1 interrupt Init */
    HAL_NVIC_SetPriority(TIM1_UP_TIM16_IRQn, 1, 0);
    HAL_NVIC_EnableIRQ(TIM1_UP_TIM16_IRQn);
    HAL_NVIC_SetPriority(TIM1_CC_IRQn, 1, 0);
    HAL_NVIC_EnableIRQ(TIM1_CC_IRQn);
  }
  else if(tim_baseHandle->Instance==TIM2)
  {
    /* TIM2 clock enable */
    __HAL_RCC_TIM2_CLK_ENABLE();

    /* TIM2 interrupt Init */
    HAL_NVIC_SetPriority(TIM2_IRQn, 8, 0);
    HAL_NVIC_EnableIRQ(TIM2_IRQn);
  }
}

void HAL_TIM_Base_MspDeInit(TIM_HandleTypeDef* tim_baseHandle)
{

  if(tim_baseHandle->Instance==TIM1)
  {
    /* Peripheral clock disable */
    __HAL_RCC_TIM1_CLK_DISABLE();

    /* TIM1 interrupt Deinit */
    HAL_NVIC_DisableIRQ(TIM1_UP_TIM16_IRQn);
    HAL_NVIC_DisableIRQ(TIM1_CC_IRQn);
  }
  else if(tim_baseHandle->Instance==TIM2)
  {
    /* Peripheral clock disable */
    __HAL_RCC_TIM2_CLK_DISABLE();

    /* TIM2 interrupt Deinit */
    HAL_NVIC_DisableIRQ(TIM2_IRQn);
  }
}

/* USER CODE BEGIN 1 */

/* ======================== 7. 接口函数实现 ======================== */
/* 无 */

/* ======================== 8. 私有函数实现 ======================== */
/* 无 */

/* ======================== 9. HAL 回调函数实现 ======================== */

/**
 * @brief 定时器更新事件（UEV）回调
 * @details TIM1 每 1ms 触发一次 UART3 电机编码器请求；TIM2 周期内刷新 IWDG 喂狗。
 * @param htim 触发回调的定时器句柄（按 Instance 区分 TIM1 / TIM2）
 */
void HAL_TIM_PeriodElapsedCallback(TIM_HandleTypeDef *htim)
{
    if (htim->Instance == TIM1)
    {
        Drv_Loc_EncoderTrigger_SendOne(ENCODER_UART_MOTOR);
    }
    else if (htim->Instance == TIM2)
    {
        static uint16_t s_led_blue_tick_cnt = 0U;

        /* TIM2 UEV 周期约 200ms（PSC=1699、ARR=19999、TIMCLK≈170MHz）；IWDG 超时约 512ms，须保证该周期远小于超时 */
        (void)HAL_IWDG_Refresh(&hiwdg);

        /* LED_BLUE 每 1s 翻转一次；LED_RED 上电拉高(熄灭)后保持 */
        s_led_blue_tick_cnt++;
        if (s_led_blue_tick_cnt >= LED_BLUE_TOGGLE_TICKS)
        {
            s_led_blue_tick_cnt = 0U;
            HAL_GPIO_TogglePin(LED_BLUE_GPIO_Port, LED_BLUE_Pin);
        }
    }
}

/**
 * @brief 定时器输出比较（OC）延时事件回调
 * @details 仅处理 TIM1：CH1（≈0.20ms，Pulse=1999）触发 UART4 摆杆编码器；
 *          CH2（≈0.40ms，Pulse=3999）触发 UART5 输出轴编码器。
 *          三路编码器请求错相位发出，避免同一时刻并发收发。
 * @param htim 触发回调的定时器句柄（仅 TIM1 生效，按 Channel 区分通道）
 */
void HAL_TIM_OC_DelayElapsedCallback(TIM_HandleTypeDef *htim)
{
    if (htim->Instance != TIM1)
    {
        return;
    }
    if ((htim->Channel == HAL_TIM_ACTIVE_CHANNEL_1))
    {
        Drv_Loc_EncoderTrigger_SendOne(ENCODER_UART_SWING);
    }
    else if (htim->Channel == HAL_TIM_ACTIVE_CHANNEL_2)
    {
        Drv_Loc_EncoderTrigger_SendOne(ENCODER_UART_SHAFT);  /* CH2，≈0.40ms（Pulse=3999） */
    }
}



/* USER CODE END 1 */
