YiChenHai7296/PendulumDriveFW/Core/Src/dma.c

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

/* Includes ------------------------------------------------------------------*/
#include "dma.h"

/* USER CODE BEGIN 0 */
/* ======================== 1. 头文件引用（本文件额外） ======================== */
/* 无 */

/* ======================== 2. 私有宏定义 ======================== */
/* 无 */

/* ======================== 3. 私有类型定义 ======================== */
/* 无 */

/* ======================== 4. 对外变量定义 ======================== */
/* 无 */

/* ======================== 5. 私有变量 ======================== */
/* 无 */

/* ======================== 6. 私有函数声明 ======================== */
/* 无 */
/* USER CODE END 0 */

/*----------------------------------------------------------------------------*/
/* Configure DMA                                                              */
/*----------------------------------------------------------------------------*/

/**
  * Enable DMA controller clock
  */
void MX_DMA_Init(void)
{

  /* DMA controller clock enable */
  __HAL_RCC_DMAMUX1_CLK_ENABLE();
  __HAL_RCC_DMA1_CLK_ENABLE();
  __HAL_RCC_DMA2_CLK_ENABLE();

  /* DMA interrupt init */
  /* DMA1_Channel1_IRQn interrupt configuration */
  HAL_NVIC_SetPriority(DMA1_Channel1_IRQn, 7, 0);
  HAL_NVIC_EnableIRQ(DMA1_Channel1_IRQn);
  /* DMA1_Channel2_IRQn interrupt configuration */
  HAL_NVIC_SetPriority(DMA1_Channel2_IRQn, 7, 0);
  HAL_NVIC_EnableIRQ(DMA1_Channel2_IRQn);
  /* DMA1_Channel3_IRQn interrupt configuration */
  HAL_NVIC_SetPriority(DMA1_Channel3_IRQn, 6, 0);
  HAL_NVIC_EnableIRQ(DMA1_Channel3_IRQn);
  /* DMA1_Channel4_IRQn interrupt configuration */
  HAL_NVIC_SetPriority(DMA1_Channel4_IRQn, 6, 0);
  HAL_NVIC_EnableIRQ(DMA1_Channel4_IRQn);
  /* DMA1_Channel5_IRQn interrupt configuration */
  HAL_NVIC_SetPriority(DMA1_Channel5_IRQn, 7, 0);
  HAL_NVIC_EnableIRQ(DMA1_Channel5_IRQn);
  /* DMA1_Channel6_IRQn interrupt configuration */
  HAL_NVIC_SetPriority(DMA1_Channel6_IRQn, 6, 0);
  HAL_NVIC_EnableIRQ(DMA1_Channel6_IRQn);
  /* DMA2_Channel1_IRQn interrupt configuration */
  HAL_NVIC_SetPriority(DMA2_Channel1_IRQn, 5, 0);
  HAL_NVIC_EnableIRQ(DMA2_Channel1_IRQn);
  /* DMA2_Channel2_IRQn interrupt configuration */
  HAL_NVIC_SetPriority(DMA2_Channel2_IRQn, 5, 0);
  HAL_NVIC_EnableIRQ(DMA2_Channel2_IRQn);
  /* DMA2_Channel3_IRQn interrupt configuration */
  HAL_NVIC_SetPriority(DMA2_Channel3_IRQn, 5, 0);
  HAL_NVIC_EnableIRQ(DMA2_Channel3_IRQn);
  /* DMA1_Channel8_IRQn interrupt configuration */
  HAL_NVIC_SetPriority(DMA1_Channel8_IRQn, 6, 0);
  HAL_NVIC_EnableIRQ(DMA1_Channel8_IRQn);

}

/* USER CODE BEGIN 2 */
/* ======================== 7. 接口函数实现 ======================== */
/* 无 */

/* ======================== 8. 私有函数实现 ======================== */
/* 无 */

/* ======================== 9. HAL 回调函数实现 ======================== */
/* 无 */

/* USER CODE END 2 */
