YiChenHai7296/PendulumDriveFW/Core/Src/crc.c

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
/* Includes ------------------------------------------------------------------*/
#include "crc.h"

/* USER CODE BEGIN 0 */
/* ======================== 1. 头文件引用（本文件额外） ======================== */
/* 无 */

/* ======================== 2. 私有宏定义 ======================== */
/* 无 */

/* ======================== 3. 私有类型定义 ======================== */
/* 无 */

/* ======================== 4. 对外变量定义 ======================== */
/* 无 */

/* ======================== 5. 私有变量 ======================== */
/* 无 */

/* ======================== 6. 私有函数声明 ======================== */
/* 无 */
/* USER CODE END 0 */

CRC_HandleTypeDef hcrc;

/* CRC init function */
void MX_CRC_Init(void)
{

  hcrc.Instance = CRC;
  hcrc.Init.DefaultPolynomialUse = DEFAULT_POLYNOMIAL_DISABLE;
  hcrc.Init.DefaultInitValueUse = DEFAULT_INIT_VALUE_DISABLE;
  hcrc.Init.GeneratingPolynomial = 32773;
  hcrc.Init.CRCLength = CRC_POLYLENGTH_16B;
  hcrc.Init.InitValue = 0xFFFF;
  hcrc.Init.InputDataInversionMode = CRC_INPUTDATA_INVERSION_BYTE;
  hcrc.Init.OutputDataInversionMode = CRC_OUTPUTDATA_INVERSION_ENABLE;
  hcrc.InputDataFormat = CRC_INPUTDATA_FORMAT_BYTES;
  if (HAL_CRC_Init(&hcrc) != HAL_OK)
  {
    Error_Handler();
  }
}

void HAL_CRC_MspInit(CRC_HandleTypeDef* crcHandle)
{

  if(crcHandle->Instance==CRC)
  {
    /* CRC clock enable */
    __HAL_RCC_CRC_CLK_ENABLE();
  }
}

void HAL_CRC_MspDeInit(CRC_HandleTypeDef* crcHandle)
{

  if(crcHandle->Instance==CRC)
  {
    /* Peripheral clock disable */
    __HAL_RCC_CRC_CLK_DISABLE();
  }
}

/* USER CODE BEGIN 1 */

/* ======================== 7. 接口函数实现 ======================== */
/* 无 */

/* ======================== 8. 私有函数实现 ======================== */
/* 无 */

/* ======================== 9. HAL 回调函数实现 ======================== */
/* 无 */

/* USER CODE END 1 */
