YiChenHai7296/PendulumDriveFW/(commit log)

2026-01-09 仓库建立
2026-01-19 版本同步
2026-01-19 adc.c修改
2026-01-27 保存状态 260127
2026-01-27 simulink协议栈完成
2026-02-02 串口接收逻辑修改
2026-02-03 修复乱码，usart.c及协议层完成
2026-02-04 电机服务模块完成编码
2026-02-04 增加使能和方向GPIO
2026-02-05 无乱码第一版
2026-02-05 乱码处理完 1
2026-02-05 乱码解决 多余文件删除
2026-02-05 乱码解决 多余文件删除 2
2026-02-05 乱码解决 多余文件删除 3
2026-02-05 修改底层串口接收逻辑
2026-02-06 功能走通 v1.0
2026-02-06 实机测试前调试完成版本
2026-02-06 实际测试 0206-1
2026-02-09 修改优先级前
2026-02-09 全流程走通 编码器问题待解决
2026-02-10 大致可用第一版
2026-02-10 优先级重调，测试前
2026-02-10 测试完成 可以提交正式分支
2026-02-10 删除过程文件 测试完成 可以提交正式分支
2026-02-11 去除无用中断
2026-02-11 修复usart.h乱码 删除无用文件
2026-02-11 rename解决，releaseV1.0
2026-03-27 添加零点标定(准备删除前备份)
2026-03-27 添加零点标定(准备删除前备份)2
2026-03-27 修复adc标定时机问题
2026-03-30 V1.1版本 Release
2026-03-30 md readme测试
2026-03-30 串口实时数据上传问题
2026-03-30 添加pwm死区映射转换函数
2026-04-27 去掉拟合
2026-04-28 pwm映射加入
2026-04-28 adc1 pwm测试完成
2026-04-28 测试版本
2026-04-30 adc标零失效恢复
2026-04-30 adc上报一致性问题编码修改 待验证
2026-05-08 整版大改，规范化文档化
2026-05-12 重构ing
2026-05-13 bsp、common横向层添加
2026-05-14 v1.4备份
2026-05-14 全部提交
2026-05-14 可用版本
2026-05-18 编码器首字节误码问题解决
2026-05-19 1.3收尾
2026-05-19 readme修改
2026-05-22 simulink上位机串口升到921600 丢包问题解决
2026-05-28 adc3dma连续请求开启
2026-05-28 软尺摆加入
2026-06-02 电机速度反馈问题定位完成，添加对象选择宏定义
2026-06-09 新增config模块，bsp新增初始化
2026-06-09 变量命名规范化
2026-06-10 增加版本号强制打印 规范命名
2026-06-10 大修存档
2026-06-11 串口硬件错误调试函数最后一版保留
2026-06-22 文档化 修改
2026-06-22 readme更新
2026-06-22 文档测试
2026-06-23 测试无误 可做release
2026-06-23 docs文档上传
2026-06-23 readme链接文档
2026-06-24 工程重命名 测试无误
2026-06-26 LED功能加入
2026-06-27 文档更新：补充硬件章节、整理图示，并同步 LED CubeMX 配置。
2026-06-27 文档更新
2026-06-27 硬件测试上传
2026-06-27 readme 更新
2026-06-27 文档修改
2026-06-29 仓库更名更新
